Farouta/Custom-Flight-Controller/electric/assets/WhatsApp Image 2026-10-19 at 21.59.48 (2).jpeg

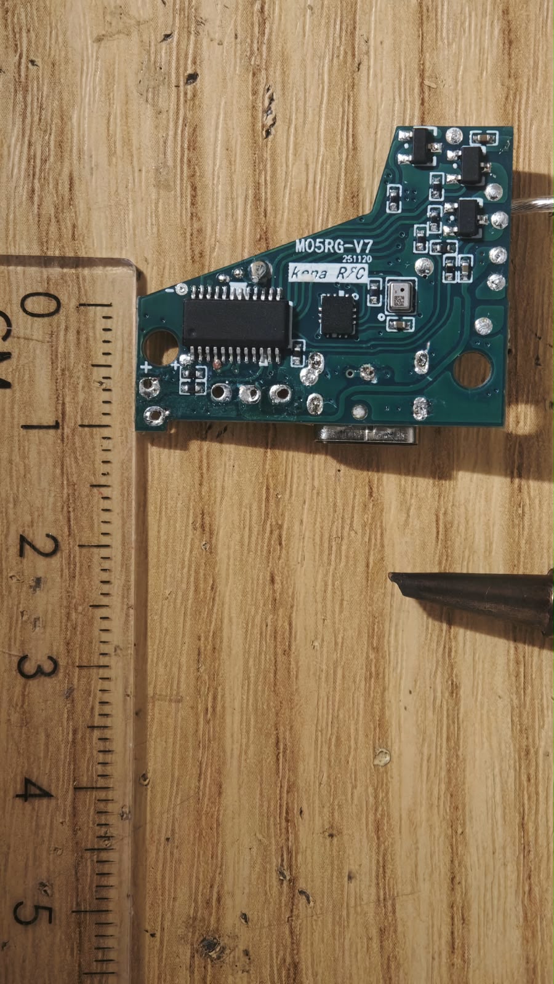
electric/assets/WhatsApp Image 2026-10-19 at 21.59.48 (2).jpeg
