Farouta/Custom-Flight-Controller/electric/assets/WhatsApp Image 2026-10-19 at 21.59.48.jpeg

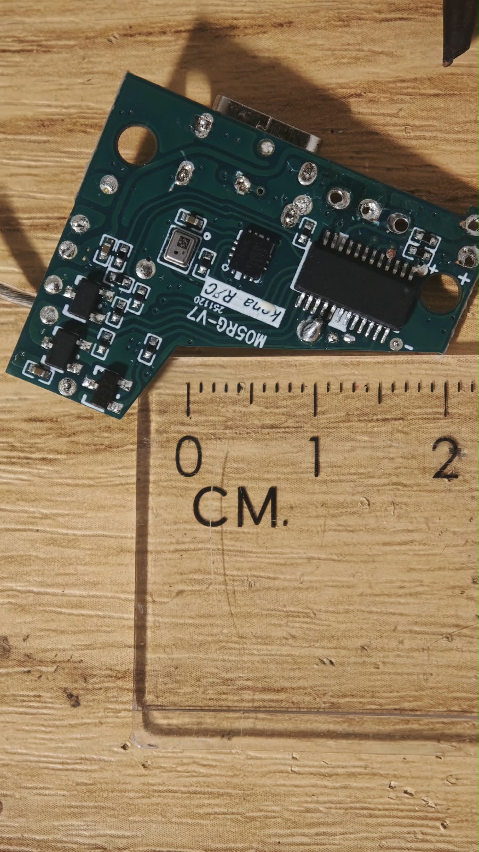
electric/assets/WhatsApp Image 2026-10-19 at 21.59.48.jpeg
