Farouta/Custom-Flight-Controller/electric/wires.txt

MotorL: black: ML- // red: M+
MotorR: black: MR- // white: M+
tail motor: red: B // black: F
LED: red: + // yellow: L
battery: red:V+ // balck: V-
