Farouta/Custom-Flight-Controller/electric/Kicad_v1/Helicopter.kicad_sch

## KiCad design electric/Kicad_v1/Helicopter.kicad_sch (2026-10-25)

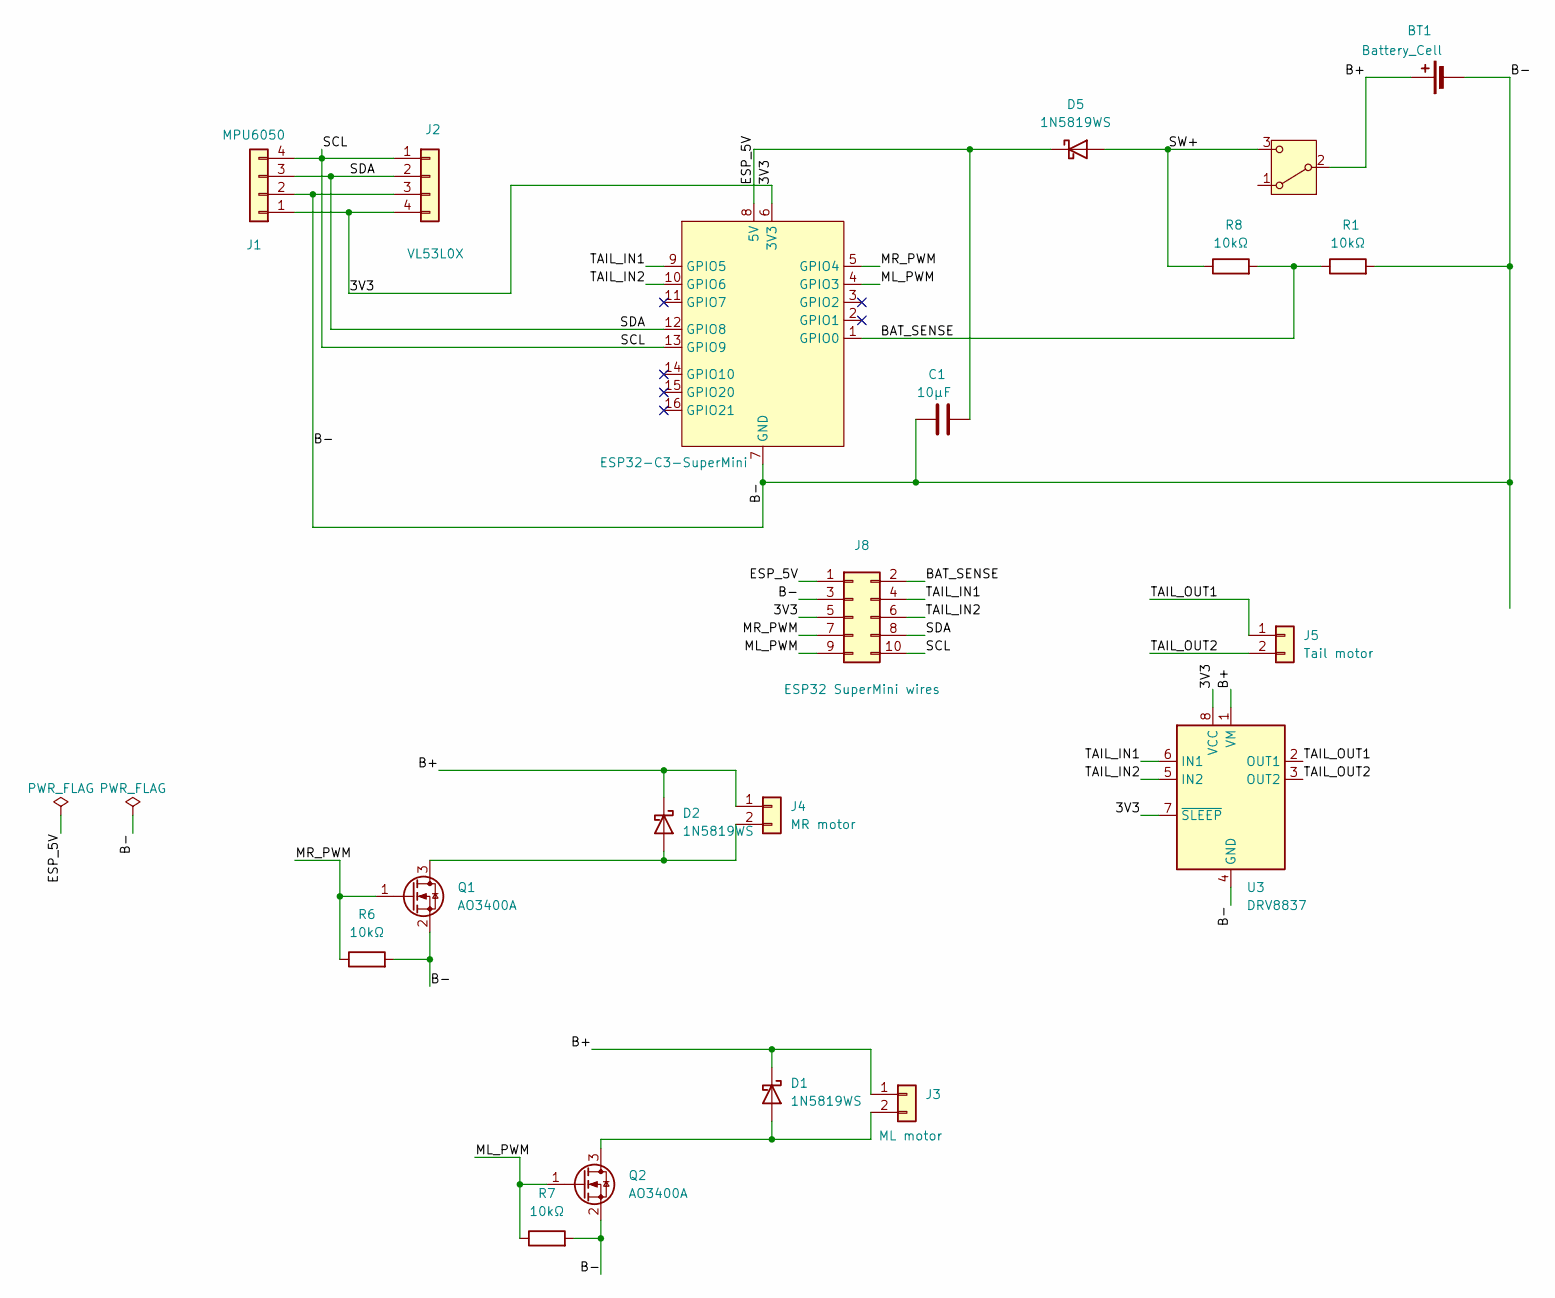
[picture p9: schematic Helicopter.kicad_sch]

Parts:
BT1: Battery_Cell; WireHoles_1x02_P2.00mm
C1: 10µF; C_0805_2012Metric
D1, D2, D5: 1N5819WS; D_SOD-323
J1: MPU6050; WireHoles_1x04_P2.00mm
J2: VL53L0X; WireHoles_1x04_P2.00mm
J3: ML motor; WireHoles_1x02_P2.00mm
J4: MR motor; WireHoles_1x02_P2.00mm
J5: Tail motor; WireHoles_1x02_P2.00mm
J8: ESP32 SuperMini wires; WireHoles_2x05_P2.00mm
Q1, Q2: AO3400A; SOT-23
R1, R6, R7, R8: 10kΩ; R_0402_1005Metric
SW1: SW_SPDT; PinHeader_1x03_P2.54mm_Vertical
U1: ESP32-C3-SuperMini; PinHeader_2x05_P2.54mm_Vertical
U3: DRV8837; WSON-8-1EP_2x2mm_P0.5mm_EP0.9x1.6mm

Connections:
3V3: C1.2, D5.1 (K), J1.1, J2.4, J8.1, J8.5, U1.6 (3V3), U1.8 (5V), U3.7 (~SLEEP), U3.8 (VCC)
B+: BT1.1 (+), D1.1 (K), D2.1 (K), J3.1, J4.1, SW1.2 (B), U3.1 (VM)
B-: BT1.2 (-), C1.1, J1.2, J2.3, J8.3, Q1.2 (S), Q2.2 (S), R1.2, R6.2, R7.2, U1.7 (GND), U3.4 (GND), U3.9 (GND)
BAT_SENSE: J8.2, R1.1, R8.2, U1.1 (GPIO0)
ML_PWM: J8.9, Q2.1 (G), R7.1, U1.4 (GPIO3)
MR_PWM: J8.7, Q1.1 (G), R6.1, U1.5 (GPIO4)
unnamed: D1.2 (A), J3.2, Q2.3 (D)
unnamed: D2.2 (A), J4.2, Q1.3 (D)
SCL: J1.4, J2.1, J8.10, U1.13 (GPIO9)
SDA: J1.3, J2.2, J8.8, U1.12 (GPIO8)
SW+: D5.2 (A), R8.1, SW1.3 (C)
TAIL_IN1: J8.4, U1.9 (GPIO5), U3.6 (IN1)
TAIL_IN2: J8.6, U1.10 (GPIO6), U3.5 (IN2)
TAIL_OUT1: J5.1, U3.2 (OUT1)
TAIL_OUT2: J5.2, U3.3 (OUT2)
